Hermitage-PoleNumerique/Cesure-William/images/board_v0.jpg

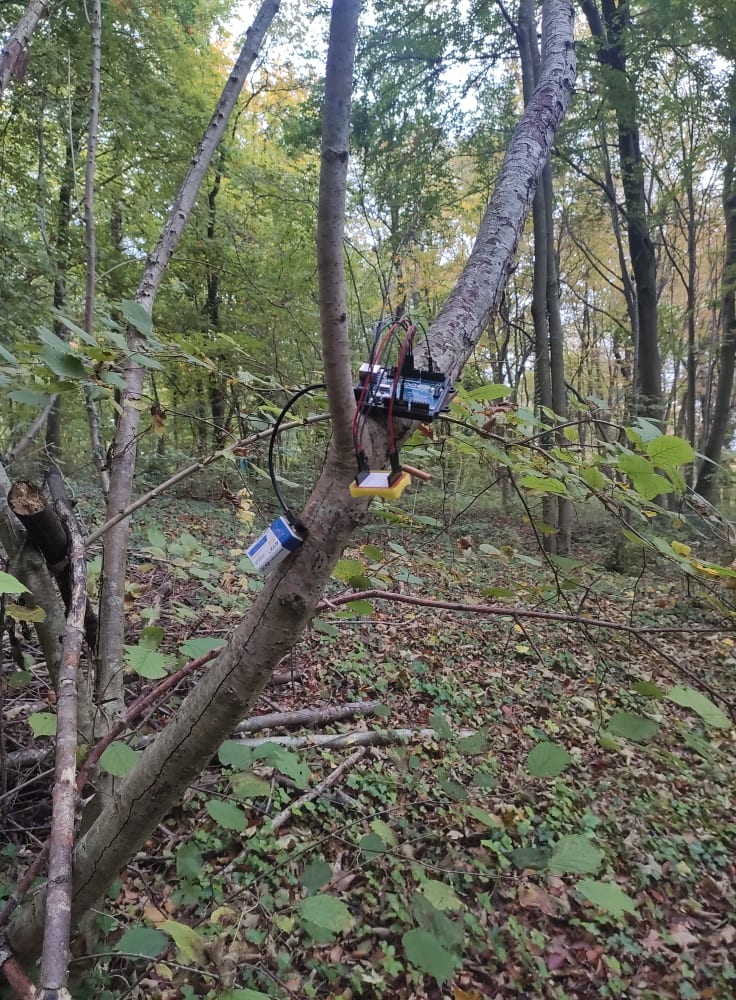
images/board_v0.jpg
