Hermitage-PoleNumerique/Cesure-William/mesures_testPorteeHer_2022-06-17.ods

false |  | false | false | false | false
dateTime:RFC3339 |  | double | double | double | double
_time | position | i_id | i_burst | rssi | snr | commentaires
2022-06-17T13:59:02Z | 2 | 61 | 0 | -102 | 2.25
2022-06-17T13:59:04Z | 2
2022-06-17T13:59:06Z | 2
2022-06-17T13:59:08Z | 2 | 63 | 2 | -101 | 4.25
2022-06-17T13:59:10Z | 2
2022-06-17T13:59:24Z | 2
2022-06-17T13:59:26Z | 2 | 63 | 6 | -109 | -6.5
2022-06-17T13:59:28Z | 2
2022-06-17T13:59:30Z | 2 | 63 | 7 | -109 | -7.25
2022-06-17T13:59:32Z | 2
2022-06-17T13:59:34Z | 2
2022-06-17T13:59:36Z | 2 | 63 | 8 | -109 | -5.75
2022-06-17T13:59:38Z | 2
2022-06-17T13:59:40Z | 2 | 63 | 9 | -108 | -5
 | Nbr pqt reçu : n |  | E[RSSI] | o[RSSI] |  | E[RSSI] | o[RSSI]
 | 6 |  | -106.333333333333 | 3.4480268109295 |  | -3 | 4.50924975282289
2022-06-17T14:01:44Z | 3 | 64 | 0 | -107 | -2.25 | L’Anthurium ne travail pas ajd… Contrairement au premier test
2022-06-17T14:01:46Z | 3
2022-06-17T14:01:48Z | 3
2022-06-17T14:01:50Z | 3 | 64 | 1 | -106 | 0.25
2022-06-17T14:01:52Z | 3
2022-06-17T14:01:54Z | 3 | 64 | 2 | -107 | -1.25
2022-06-17T14:01:56Z | 3
2022-06-17T14:01:58Z | 3 | 64 | 3 | -107 | -6.25
2022-06-17T14:02:00Z | 3
2022-06-17T14:02:02Z | 3
2022-06-17T14:02:04Z | 3 | 64 | 4 | -109 | -7
2022-06-17T14:02:06Z | 3
2022-06-17T14:02:08Z | 3 | 64 | 5 | -103 | 1.75
2022-06-17T14:02:10Z | 3
2022-06-17T14:02:12Z | 3 | 64 | 6 | -103 | 0.5
2022-06-17T14:02:14Z | 3
2022-06-17T14:02:16Z | 3
2022-06-17T14:02:18Z | 3 | 64 | 7 | -106 | -1.25
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
2022-06-17T16:01:30Z | 28 | 134 | 8 | -108 | -5
2022-06-17T16:01:42Z | 28
2022-06-17T16:01:44Z | 28 | 134 | 9 | -107 | -5.5
 | Nbr pqt reçu : n |  | E[RSSI] | o[RSSI] |  | E[RSSI] | o[RSSI]
 | 8 |  | -107.875 | 1.36358901432946 |  | -5.78125 | 1.44933982816315
06:04:00 PM | 29 |  |  |  |  | R
