Hermitage-PoleNumerique/Cesure-William/cartesMesures_testsPorteeHer.pdf

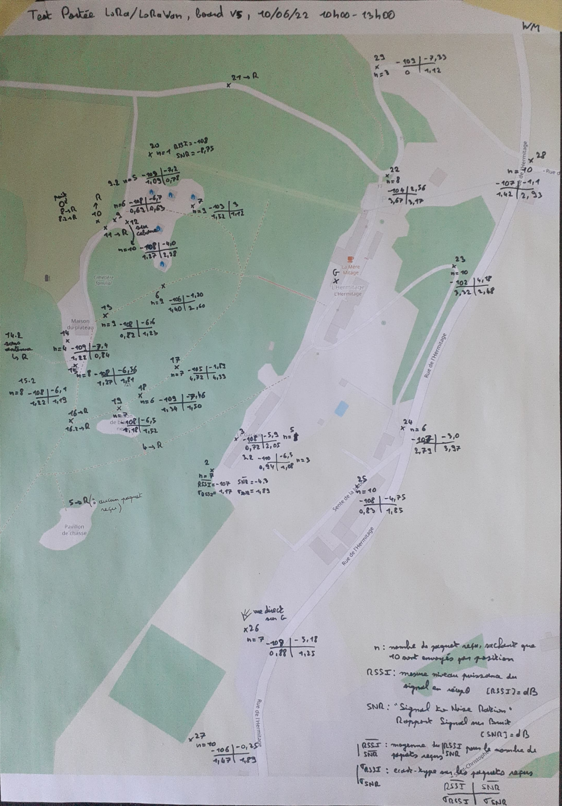
[picture p11: page 1]

*

ela

# beyuaH aHI3P ony

# Rue de l'Hermitage

# Rue de l'Hermitage

ge

# Termitag9e

ente e de

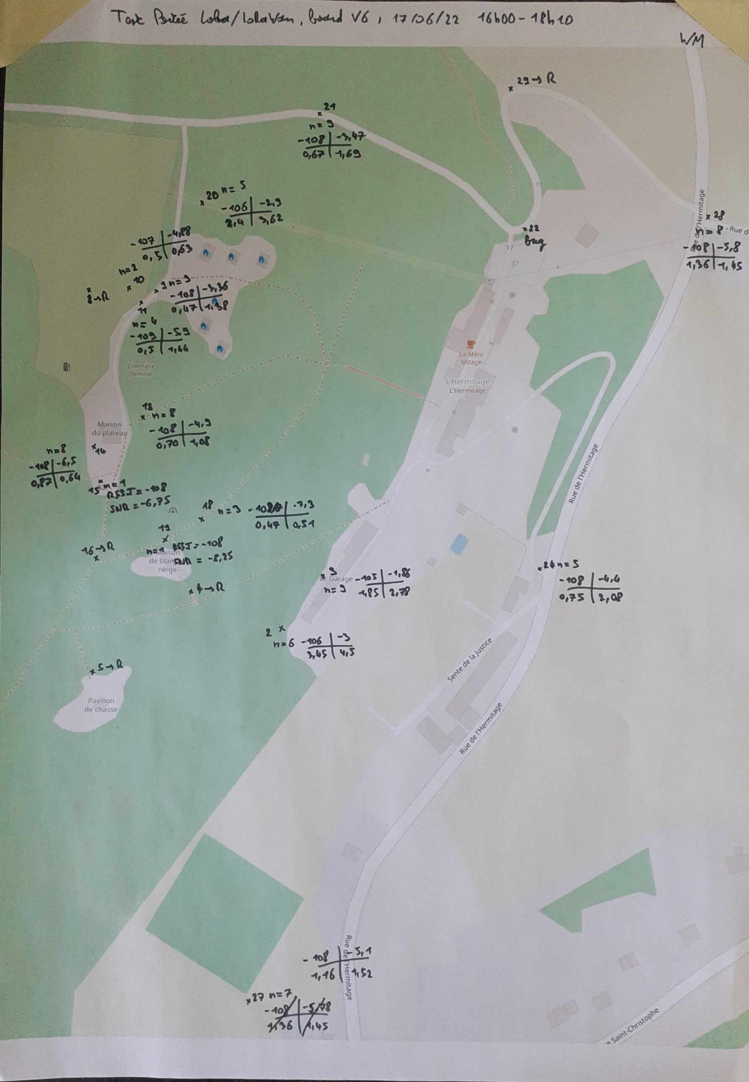
[picture p12: page 2]

6

Sente de la

Justice

# abeuaH

# Rue de I'Hermitage

# Rue de 'Hermitage

# Hermitage

## Christophe
