Hermitage-PoleNumerique/Cesure-William/mesures_testPorteeHer_2022-06-15.ods

_time | i_position_her | i_id | i_burst | rssi | snr | commentaires |  |  |  |  |  |  |  | commentaires
 | 1
2022-06-10T08:03:36Z | 1 | 8 | 0 | -107 | 0 | passage d’Alexandre
2022-06-10T08:03:38Z | 1
2022-06-10T08:03:40Z | 1 | 8 | 1 | -104 | 1.75
2022-06-10T08:03:42Z | 1
2022-06-10T08:03:44Z | 1 | 8 | 2 | -102 | 5.5
2022-06-10T08:03:46Z | 1
2022-06-10T08:03:48Z | 1 |  |  |  |  | bizzare qu’il y ait autant de paquets sans valeur → uniquement pour l’adr ? Préfère écarter ces données
2022-06-10T08:03:50Z | 1 |  |  | -103 | 1.75
2022-06-10T08:03:52Z | 1
2022-06-10T08:03:54Z | 1 |  |  | -105 | 1.75
2022-06-10T08:03:56Z | 1
2022-06-10T08:03:58Z | 1 |  |  | -109 | -4.5
2022-06-10T08:04:00Z | 1
2022-06-10T08:04:02Z | 1 |  |  | -111 | -6.5
2022-06-10T08:04:04Z | 1
2022-06-10T08:04:06Z | 1
2022-06-10T08:04:08Z | 1 |  |  | -108 | -4.5
2022-06-10T08:04:10Z | 1
2022-06-10T08:04:12Z | 1 |  |  | -109 | -7.5
_time | i_position_her | i_id | i_burst | rssi | snr
2022-06-10T08:05:18Z | 2 | 9 | 1 | -109 | -8
2022-06-10T08:05:20Z | 2
2022-06-10T08:05:24Z | 2
2022-06-10T08:05:26Z | 2 | 9 | 3 | -106 | -4.25
2022-06-10T08:05:28Z | 2
2022-06-10T08:05:30Z | 2
2022-06-10T08:05:32Z | 2 | 9 | 4 | -107 | -3.5
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
