Hermitage-PoleNumerique/Cesure-William/board/Schematic_LoRaWanXHER_ArduinoProMini_v7_2022-06-29.pdf

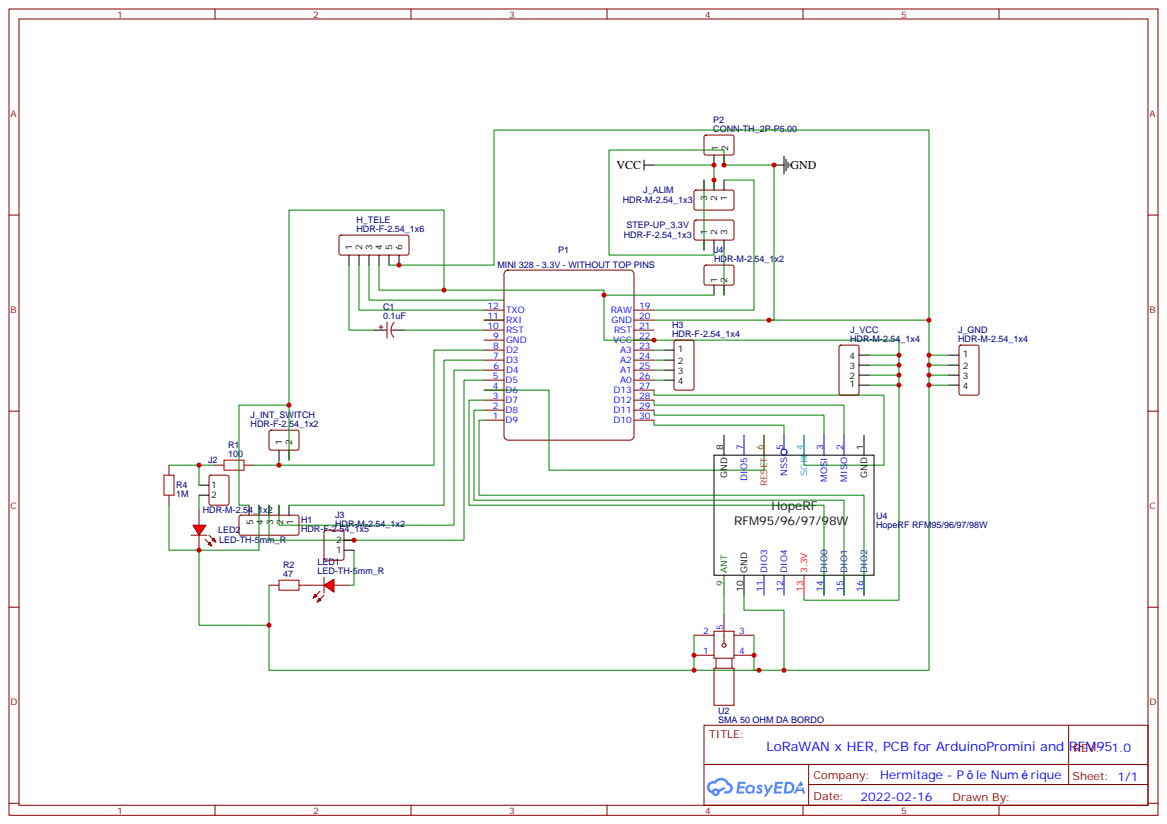
[picture p13: page 1]

MINI 328 - 3.3V - WITHOUT TOP PINS

LoRaWAN x HER, PCB for ArduinoPromini and RFM95 REV: 1.0

Company: Hermitage - P le Num rique
