Hermitage-PoleNumerique/Cesure-William/arduino_sketches/lmic_lowpower/doc/LMIC-FSM.pdf

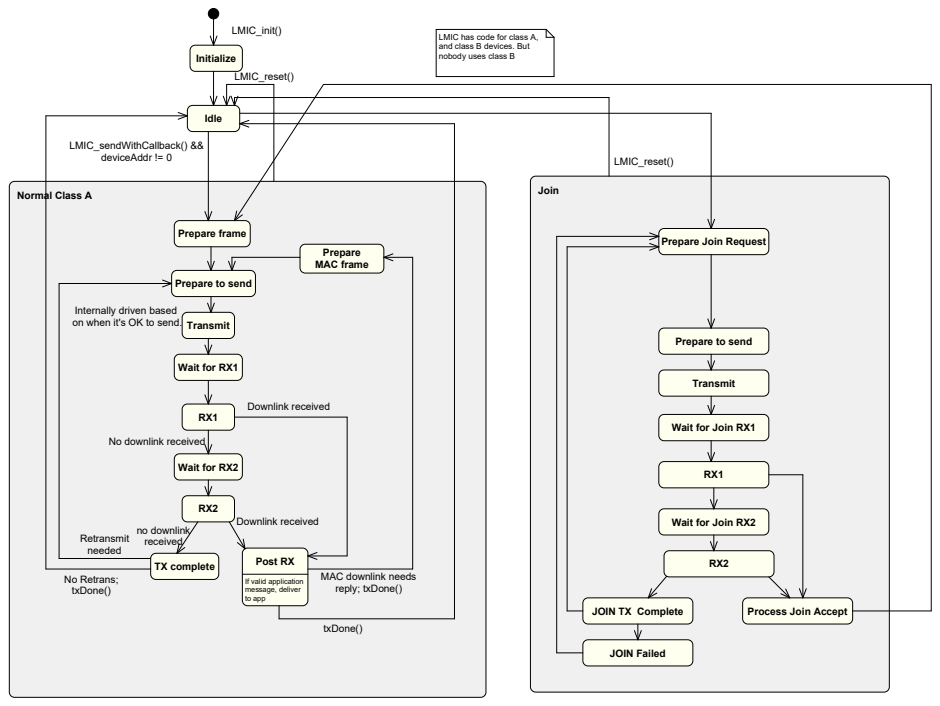
[picture p14: page 1]
Initialize; Idle; Transmit; LMIC_sendWithCallback() && deviceAddr != 0; LMIC_init(); Normal Class A; LMIC_reset(); Wait for RX1; Wait for RX2; TX complete; Downlink received; Prepare frame; Prepare MAC frame; Post RX; Retransmit needed; No Retrans; txDone(); txDone(); no downlink received; Join; JOIN TX Complete; Process Join Accept; JOIN Failed

LMIC has code for class A,
and class B devices. But
nobody uses class B

Prepare Join Request

Prepare to send

Internally driven based
on when it's OK to send.

Wait for Join RX1

No downlink received

Wait for Join RX2

MAC downlink needs
reply; txDone()

If valid application
message, deliver
to app
