Hermitage-PoleNumerique/Cesure-William/board/PCB_LoRaWanXHER_ArduinoProMini_v7_2022-06-29.pdf

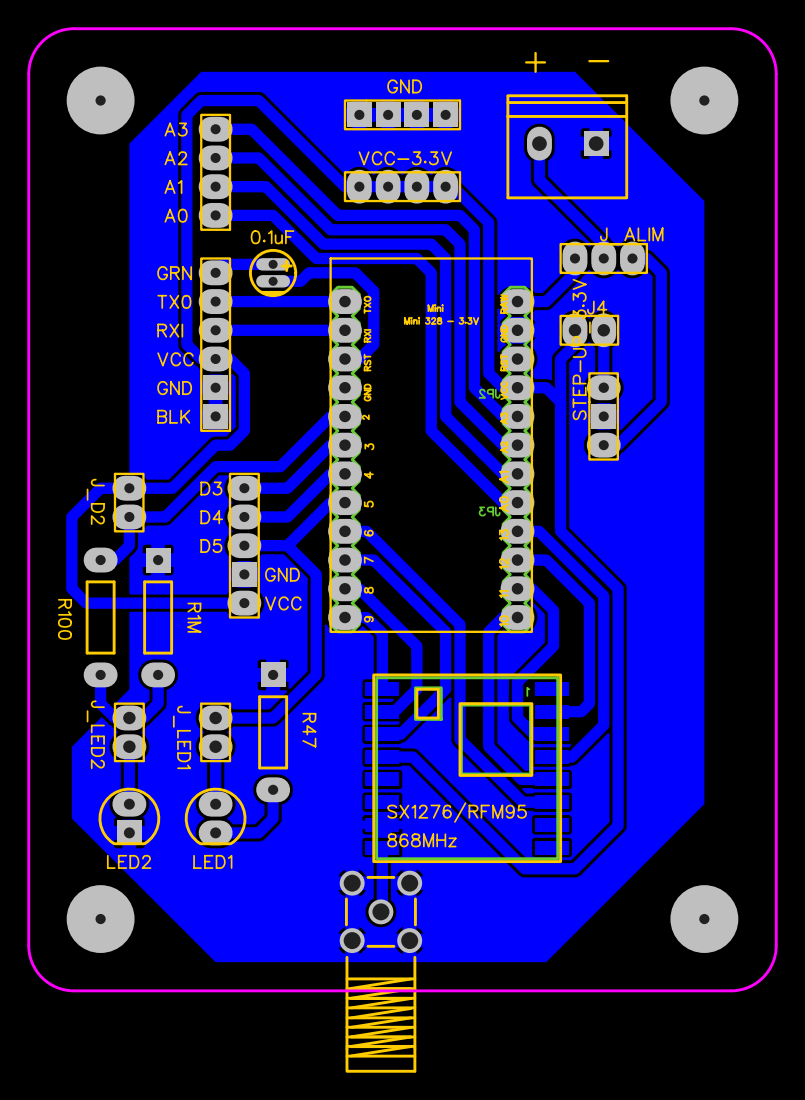
[picture p15: page 1]
