Hermitage-PoleNumerique/Cesure-William/arduino_sketches/OTAA_DHT11/src/Sensor.h

/*
* Copyright (C) 2016 Nicolas Bertuol, University of Pau, France
*
* nicolas.bertuol@etud.univ-pau.fr
* 
* Modified by C. Pham, University of Pau, France
* Modified by William Michalski, Hermitage-PoleNumerique, France
*/

#ifndef SENSOR_H
#define SENSOR_H

#if ARDUINO >= 100
 #include "Arduino.h"
#else
 #include "WProgram.h"
#endif

#define IS_ANALOG true
#define IS_NOT_ANALOG false
#define IS_CONNECTED true
#define IS_NOT_CONNECTED false
#define IS_LOWPOWER true
#define IS_NOT_LOWPOWER false

#define MAX_NOMENCLATURE_LENGTH 5

#if defined ARDUINO_AVR_PRO || defined ARDUINO_AVR_MINI || defined __MK20DX256__  || defined __MKL26Z64__ || defined __SAMD21G18A__
  // these boards work in 3.3V
  // Nexus board from Ideetron is a Mini
  // __MK20DX256__ is for Teensy31/32
  // __MKL26Z64__ is for TeensyLC
  // __SAMD21G18A__ is for Zero/M0 and FeatherM0 (Cortex-M0)
  #define _BOARD_MVOLT_SCALE  3300.0
  #define _BOARD_VOLT_SCALE  3.3  
#else // ARDUINO_AVR_NANO || defined ARDUINO_AVR_UNO || defined ARDUINO_AVR_MEGA2560
  // also for all other boards, so change here if required.
  #define _BOARD_MVOLT_SCALE  5000.0 
  #define _BOARD_VOLT_SCALE  5.0   
#endif

class Sensor {
  public:  
    Sensor(char nomenclature, bool is_analog, bool is_connected, bool is_low_power, uint8_t pin_read, uint8_t pin_power, int pin_trigger=-1);
    
    // getters
    //////////
    char get_nomenclature();
    bool get_is_analog();
    bool get_is_connected();
    bool get_is_low_power();    
    uint8_t get_pin_read();
    uint8_t get_pin_power();
    int get_pin_trigger();
    //char* get_power_set();
    double get_data();       
    uint16_t get_warmup_time();
    bool has_fake_data();
    bool has_pin_trigger();
    uint8_t get_n_sample();
        
    //setters
    /////////
    void set_is_analog(bool b);
    void set_is_connected(bool b);
    void set_is_low_power(bool b);    
    void set_pin_read(uint8_t u);
    void set_pin_power(uint8_t u);
    void set_pin_trigger(int u);    
    //void set_power_set(char* c);
    void set_data(double d);      
    void set_warmup_time(uint16_t t);
    void set_fake_data(bool b);
    void set_n_sample(uint8_t n);
    
    virtual void update_data();
    virtual double get_value();
    
  private:
  	char _nomenclature;
    bool _is_analog;
    bool _is_connected;
    bool _is_low_power;    
    uint8_t _pin_read;
    uint8_t _pin_power;
    int _pin_trigger;
    bool _with_fake_data;
    //char* _power_set = NULL;
    double _data;       
    // delay in ms before reading data, sensor is powered
    uint16_t _warmup_time;
    uint8_t _n_sample;
};

#endif
