Hermitage-PoleNumerique/Cesure-William/arduino_sketches/OTAA_HCSR04/src/HCSR04.h

/*
* Copyright (C) William Michalski, Hermitage-PoleNumerique, France
*
*/

#ifndef HCSR04_H
#define HCSR04_H

#include "Sensor.h"

class HCSR04 : public Sensor {
  public:
    HCSR04(char nomenclature, bool is_analog, bool is_connected, bool is_low_power, uint8_t pin_read, uint8_t pin_power, int pin_trigger);
    double get_value();
    void update_data();
};

#endif
