Hermitage-PoleNumerique/Cesure-William/(commit log)

2022-06-28 Ajout de CC license
2022-06-29 Ajout doc
    [mesures_testPorteeHer_2022-06-15.ods, mesures_testPorteeHer_2022-06-17.ods]
2022-06-29 Doc arduino_sketches
2022-07-01 photos boards
